karimrayttu/bldc-predictive-maintenance/docs/photos/README.md

# Bench photos

| File | What it is |
|---|---|
| `bench_overheat_test.jpg` | The full bench during an induced overheat run. Motor and sensing hardware on the rail at left, the Raspberry Pi 5 touchscreen dashboard on its printed stand at right, showing the OVERHEAT banner with 1318 rpm, 0.076 A bus current, 109.6 °C case temperature and 45 mg vibration RMS. |
| `bench_overheat_dashboard_cutout.png` | The same setup, background removed; used as a figure in the write-up. |
| `perfboard_temp_current_sensor.jpg` | Close-up of the hand-built perfboard sense node: INA240A2 on a SOIC-8 breakout, the anti-alias RC, and screw terminals for the shunt Kelvin pair, the NTC divider and the supply. |

Every image was checked before being committed. No names, no identifying signage, no
readable asset tags; the lab background in `bench_overheat_test.jpg` is out of focus.
