karimrayttu/bldc-predictive-maintenance/data/commissioning_unmounted/sessions/drag/1400rpm/S031_20260621-034825/data.csv

iso_time | session_id | fixture_state | valid_for_classifier | condition | severity | speed_setpoint_rpm | label | t_ms | rpm | ripple_permil | min_us | max_us | hall | illegal | edges | step | coast_ms | period_std_permil | mech1x_permil | elec_permil | accel_rms_g | accel_pk_g | temp_motor_c | temp_ambient_c | i_u_a | i_v_a | i_w_a | i_dc_a | modbus_rpm | modbus_fault
2026-06-21T03:48:25.575782+00:00 | S031 | commissioning_unmounted | false | drag | mild | 1400 | drag-mild_horizontal_no_load_1400rpm | 3361598 | 1397 | 272 | 1537 | 2025 | 6 | 50 | 1467668 | 9 | 490 | 73 | 0 | 1
2026-06-21T03:48:25.669075+00:00 | S031 | commissioning_unmounted | false | drag | mild | 1400 | drag-mild_horizontal_no_load_1400rpm | 3361698 | 1398 | 279 | 1531 | 2031 | 3 | 50 | 1467724 | 9 | 490 | 76 | 0 | 2
2026-06-21T03:48:25.762644+00:00 | S031 | commissioning_unmounted | false | drag | mild | 1400 | drag-mild_horizontal_no_load_1400rpm | 3361798 | 1398 | 280 | 1529 | 2031 | 1 | 50 | 1467779 | 9 | 490 | 75 | 0 | 1
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
