karimrayttu/bldc-predictive-maintenance/data/commissioning_unmounted/sessions/healthy/0500rpm/S007_20260620-131703/data.csv

iso_time | session_id | fixture_state | valid_for_classifier | condition | severity | speed_setpoint_rpm | label | t_ms | rpm | ripple_permil | min_us | max_us | hall | illegal | edges | step | coast_ms | accel_rms_g | accel_pk_g | temp_motor_c | temp_ambient_c | i_u_a | i_v_a | i_w_a | i_dc_a | modbus_rpm | modbus_fault
2026-06-20T13:17:03.284135+00:00 | S007 | commissioning_unmounted | false | healthy | none | 500 | healthy_horizontal_no_load_500rpm | 14900 | 499 | 260 | 4344 | 5649 | 5 | 0 | 2929 | 9 | 0
2026-06-20T13:17:03.378953+00:00 | S007 | commissioning_unmounted | false | healthy | none | 500 | healthy_horizontal_no_load_500rpm | 15000 | 499 | 260 | 4344 | 5649 | 6 | 0 | 2949 | 9 | 0
2026-06-20T13:17:03.518933+00:00 | S007 | commissioning_unmounted | false | healthy | none | 500 | healthy_horizontal_no_load_500rpm | 15100 | 499 | 248 | 4355 | 5596 | 3 | 0 | 2969 | 9 | 0
2026-06-20T13:17:03.614001+00:00 | S007 | commissioning_unmounted | false | healthy | none | 500 | healthy_horizontal_no_load_500rpm | 15200 | 501 | 247 | 4342 | 5578 | 5 | 0 | 2989 | 9 | 0
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
