karimrayttu/bldc-predictive-maintenance/data/commissioning_unmounted/sessions/healthy/0500rpm/S013_20260620-220715/data.csv

iso_time | session_id | fixture_state | valid_for_classifier | condition | severity | speed_setpoint_rpm | label | t_ms | rpm | ripple_permil | min_us | max_us | hall | illegal | edges | step | coast_ms | period_std_permil | mech1x_permil | elec_permil | accel_rms_g | accel_pk_g | temp_motor_c | temp_ambient_c | i_u_a | i_v_a | i_w_a | i_dc_a | modbus_rpm | modbus_fault
2026-06-20T22:07:15.576765+00:00 | S013 | commissioning_unmounted | false | healthy | none | 500 | healthy_horizontal_no_load_0500rpm | 8300 | 499 | 256 | 4317 | 5598 | 1 | 0 | 1597 | 9 | 0 | 73 | 7 | 2
2026-06-20T22:07:15.655802+00:00 | S013 | commissioning_unmounted | false | healthy | none | 500 | healthy_horizontal_no_load_0500rpm | 8400 | 501 | 244 | 4340 | 5556 | 4 | 0 | 1617 | 9 | 0 | 74 | 2 | 3
2026-06-20T22:07:15.765673+00:00 | S013 | commissioning_unmounted | false | healthy | none | 500 | healthy_horizontal_no_load_0500rpm | 8500 | 499 | 256 | 4322 | 5603 | 2 | 0 | 1637 | 9 | 0 | 74 | 8 | 3
2026-06-20T22:07:15.873770+00:00 | S013 | commissioning_unmounted | false | healthy | none | 500 | healthy_horizontal_no_load_0500rpm | 8600 | 500 | 254 | 4335 | 5605 | 1 | 0 | 1657 | 9 | 0 | 74 | 4 | 2
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
