karimrayttu/bldc-predictive-maintenance/data/commissioning_unmounted/sessions/healthy/0500rpm/S023_20260621-012050/data.csv

iso_time | session_id | fixture_state | valid_for_classifier | condition | severity | speed_setpoint_rpm | label | t_ms | rpm | ripple_permil | min_us | max_us | hall | illegal | edges | step | coast_ms | period_std_permil | mech1x_permil | elec_permil | accel_rms_g | accel_pk_g | temp_motor_c | temp_ambient_c | i_u_a | i_v_a | i_w_a | i_dc_a | modbus_rpm | modbus_fault
2026-06-21T01:20:50.672928+00:00 | S023 | commissioning_unmounted | false | healthy | none | 500 | healthy_horizontal_no_load_0500rpm | 3068837 | 500 | 252 | 4348 | 5611 | 3 | 16 | 276710 | 9 | 540 | 74 | 4 | 4
2026-06-21T01:20:50.768249+00:00 | S023 | commissioning_unmounted | false | healthy | none | 500 | healthy_horizontal_no_load_0500rpm | 3068937 | 499 | 262 | 4324 | 5637 | 5 | 16 | 276730 | 9 | 540 | 74 | 9 | 1
2026-06-21T01:20:50.863264+00:00 | S023 | commissioning_unmounted | false | healthy | none | 500 | healthy_horizontal_no_load_0500rpm | 3069037 | 500 | 261 | 4345 | 5650 | 6 | 16 | 276750 | 9 | 540 | 74 | 4 | 3
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
