karimrayttu/bldc-predictive-maintenance/tools/plot_dataset.py

"""Build the dataset figures used in the README from the recorded bench sessions.

    python tools/plot_dataset.py
    python tools/plot_dataset.py --include-invalid
    python tools/plot_dataset.py --data-root data/mounted_baseline --out figures
"""

from __future__ import annotations

import argparse
import json
from pathlib import Path

import matplotlib

matplotlib.use("Agg")

import matplotlib.pyplot as plt
import pandas as pd

REPO = Path(__file__).resolve().parents[1]

# Fixed slot order. Do not cycle or reorder: the ordering is what keeps the
# series separable for colour-blind readers.
CONDITION_COLOR = {
    "healthy": "#2a78d6",
    "loose_mount": "#eb6834",
    "orientation_change": "#1baf7a",
    "rotor_drag": "#eda100",
    "overheat": "#e87ba4",
}
CONDITION_ORDER = list(CONDITION_COLOR)

SURFACE = "#fcfcfb"
INK = "#0b0b0b"
INK_MUTED = "#898781"
GRID = "#e1e0d9"
BLUE_RAMP = ["#cde2fb", "#9ec5f4", "#6da7ec", "#3987e5", "#2a78d6", "#1c5cab", "#104281"]

# Raw telemetry columns that carry the fault signatures.
FEATURES = {
    "accel_rms_mg": "Vibration RMS (mg)",
    "i_dc_a": "DC bus current (A)",
    "ripple_permil": "Speed ripple (per mille)",
    "temp_motor_c": "Motor temperature (C)",
}


def style_axes(ax, title, xlabel, ylabel):
    ax.set_title(title, color=INK, fontsize=12, pad=12, loc="left")
    ax.set_xlabel(xlabel, color=INK_MUTED, fontsize=9)
    ax.set_ylabel(ylabel, color=INK_MUTED, fontsize=9)
    ax.tick_params(colors=INK_MUTED, labelsize=9)
    ax.grid(True, color=GRID, linewidth=0.8, alpha=0.9)
    ax.set_axisbelow(True)
    for side in ("top", "right"):
        ax.spines[side].set_visible(False)
    for side in ("left", "bottom"):
        ax.spines[side].set_color("#c3c2b7")


def new_figure(size=(9, 5.2)):
    fig, ax = plt.subplots(figsize=size)
    fig.patch.set_facecolor(SURFACE)
    ax.set_facecolor(SURFACE)
    return fig, ax


def save(fig, out_dir: Path, name: str):
    path = out_dir / name
    fig.tight_layout()
    fig.savefig(path, dpi=160, facecolor=SURFACE)
    plt.close(fig)
    print(f"  wrote {path.relative_to(REPO)}")


def load_sessions(data_root: Path, include_invalid: bool = False
                  ) -> tuple[pd.DataFrame, pd.DataFrame]:
    """Return (per-sample frame, per-run summary frame)."""
    frames = []
    dropped = []
    for csv in sorted(data_root.glob("sessions/*/*/*/data.csv")):
        df = pd.read_csv(csv, low_memory=False)
        if df.empty:
            continue
        run = csv.parent.name.split("_")[0]
        # meta.json is authoritative, NOT the per-row valid_for_classifier column:
        # that column is stamped on every row as the run is recorded, while the
        # verdict is written at stop time (or by a later QA sweep), so all three
        # excluded runs still carry "true" in their own data.csv.
        meta_path = csv.parent / "meta.json"
        meta = json.loads(meta_path.read_text(encoding="utf-8")) \
            if meta_path.exists() else {}
        valid = str(meta.get("valid_for_classifier", "true")).strip().lower() == "true"
        if not valid and not include_invalid:
            dropped.append(f"{csv.parent.parent.parent.name}/"
                           f"{csv.parent.parent.name}/{run}")
            continue
        df["run"] = run
        frames.append(df)

    if dropped:
        print(f"  excluded {len(dropped)} run(s) tagged valid_for_classifier=false: "
              + ", ".join(dropped))
        print("  (pass --include-invalid to plot the full recorded set instead)")

    if not frames:
        raise SystemExit(f"no sessions found under {data_root}")

    samples = pd.concat(frames, ignore_index=True)
    samples["condition"] = samples["condition"].astype(str)

    agg = {col: "mean" for col in FEATURES}
    agg["accel_pk_mg"] = "max"
    agg["rpm"] = "mean"
    runs = (
        samples.groupby(["condition", "speed_setpoint_rpm", "run"], as_index=False)
        .agg(agg)
    )
    return samples, runs


def plot_feature_vs_speed(runs: pd.DataFrame, out_dir: Path, column: str, name: str):
    """Mean of one channel against commanded speed, one line per condition."""
    fig, ax = new_figure()
    label = FEATURES[column]
    ends = []

    for condition in CONDITION_ORDER:
        sub = runs[runs["condition"] == condition]
        if sub.empty:
            continue
        curve = sub.groupby("speed_setpoint_rpm")[column].mean().sort_index()
        ax.plot(curve.index, curve.values, color=CONDITION_COLOR[condition],
                linewidth=2, marker="o", markersize=8, markeredgecolor=SURFACE,
                markeredgewidth=1.5, label=condition, zorder=3)
        ends.append([curve.index[-1], curve.values[-1], condition])

    style_axes(ax, label + " vs commanded speed", "Commanded speed (rpm)", label)
    ax.legend(frameon=False, labelcolor=INK, fontsize=9, loc="upper left")
    ax.margins(x=0.22)

    # Label only the lines that end clear of their neighbours. Where the curves
    # bunch up, a floating label points at the wrong line, so the legend and the
    # summary table carry those instead.
    lo, hi = ax.get_ylim()
    gap = (hi - lo) * 0.045
    ends.sort(key=lambda e: e[1])
    for i, (x_end, y_end, condition) in enumerate(ends):
        below = y_end - ends[i - 1][1] if i else float("inf")
        above = ends[i + 1][1] - y_end if i + 1 < len(ends) else float("inf")
        if min(below, above) >= gap:
            ax.annotate(condition, (x_end, y_end), textcoords="offset points",
                        xytext=(10, 0), color=INK, fontsize=9, va="center")
    save(fig, out_dir, name)
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
